Sonicators/PowerSupply/Electronics/Connectors.sch

## KiCad design Electronics/Connectors.sch (2015-08-16)

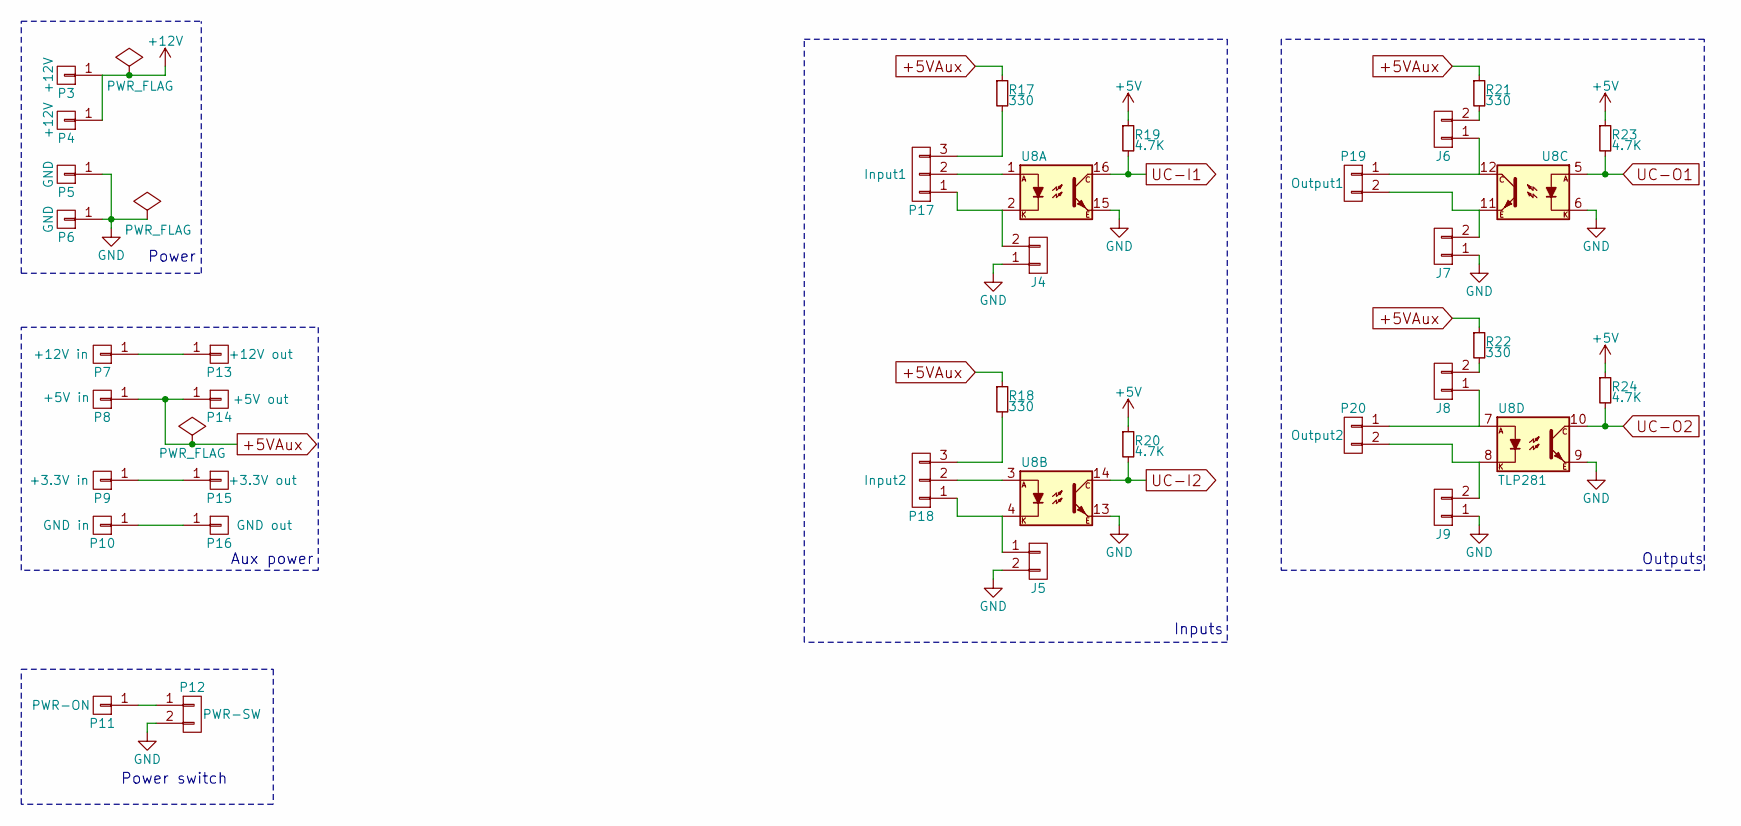
[picture p1: schematic Connectors.sch]

Parts:
J4: Input1
J5, J6, J7, J8, J9: CONN_01X02
P3, P4: +12V
P5, P6: GND
P7: +12V in
P8: +5V in
P9: +3.3V in
P10: GND in
P11: PWR-ON; SolderWirePad_single_2-5mmDrill
P12: PWR-SW; Pin_Header_Straight_1x02
P13: +12V out
P14: +5V out
P15: +3.3V out
P16: GND out
P17: Input1
P18: Input2
P19: Output1
P20: Output2
R17, R18, R21, R22: 330
R19, R20, R23, R24: 4.7K
U8: TLP281

Connections:
+5V: R19.1, R20.1, R23.1, R24.1
+5VAux: P8.1, P14.1, R17.1, R18.1, R21.1, R22.1
+12V: P3.1, P4.1
GND: J4.1, J5.2, J7.1, J9.1, P5.1, P6.1, P12.2, U8.6, U8.9, U8.13, U8.15
unnamed: J4.2, P17.1, U8.2
unnamed: J5.1, P18.1, U8.4
unnamed: J6.1, P19.1, U8.12
unnamed: J6.2, R21.2
unnamed: J7.2, P19.2, U8.11
unnamed: J8.1, P20.1, U8.7
unnamed: J8.2, R22.2
unnamed: J9.2, P20.2, U8.8
unnamed: P10.1, P16.1
unnamed: P11.1, P12.1
unnamed: P7.1, P13.1
unnamed: P9.1, P15.1
unnamed: P17.2, U8.1
unnamed: P17.3, R17.2
unnamed: P18.2, U8.3
unnamed: P18.3, R18.2
UC-I1: R19.2, U8.16
UC-I2: R20.2, U8.14
UC-O1: R23.2, U8.5
UC-O2: R24.2, U8.10

Notes on the sheet:
Aux power
Power
Inputs
Outputs
Power switch
