Sonicators/PowerSupply/Electronics/Microcontroller.sch

## KiCad design Electronics/Microcontroller.sch (2015-08-16)

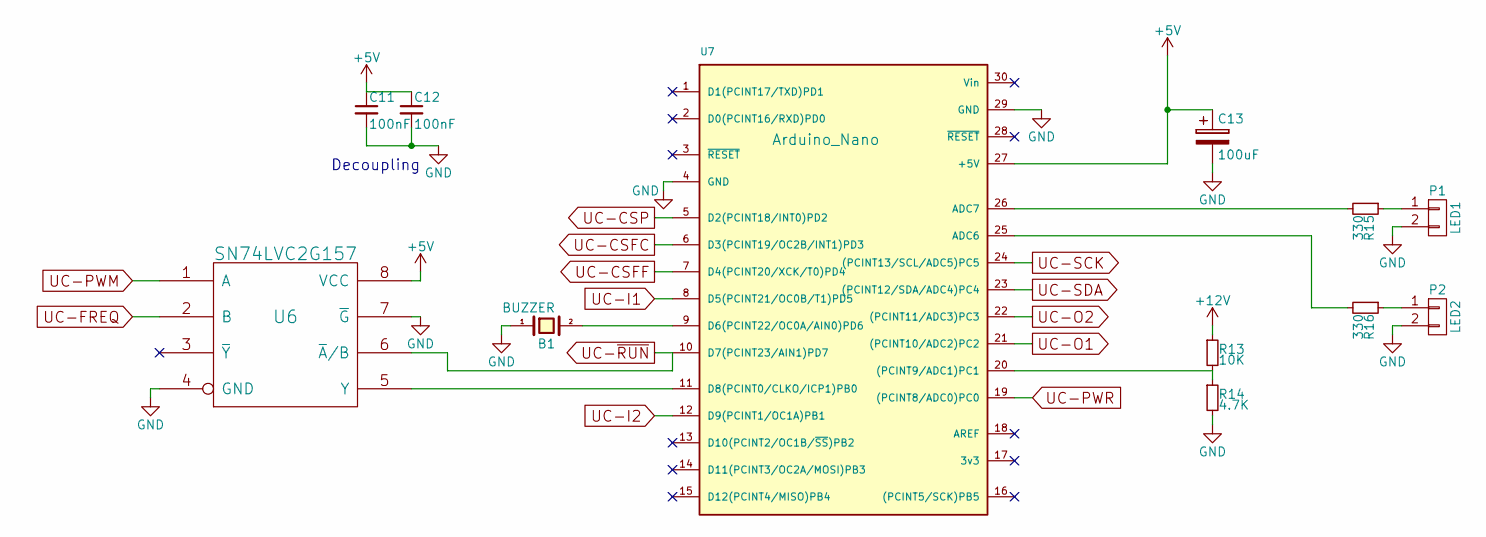
[picture p2: schematic Microcontroller.sch]

Parts:
B1: BUZZER
C11, C12: 100nF; C_0603_HandSoldering
C13: 100uF; c_elec_8x10.5
P1: LED1
P2: LED2
R13: 10K
R14: 4.7K
R15, R16: 330
U6: SN74LVC2G157
U7: Arduino_Nano

Connections:
+5V: C11.1, C12.1, C13.1, U6.8 (VCC), U7.27 (+5V)
+12V: R13.1
GND: B1.1, C11.2, C12.2, C13.2, P1.2, P2.2, R14.2, U6.4 (GND), U6.7 (~G), U7.4 (GND), U7.29 (GND)
unnamed: B1.2, U7.9 (D6(PCINT22/OC0A/AIN0)PD6)
unnamed: P1.1, R15.1
unnamed: P2.1, R16.1
unnamed: R13.2, R14.1, U7.20 ((PCINT9/ADC1)PC1)
unnamed: R15.2, U7.26 (ADC7)
unnamed: R16.2, U7.25 (ADC6)
unnamed: U6.5 (Y), U7.11 (D8(PCINT0/CLKO/ICP1)PB0)
UC-CSFC: U7.6 (D3(PCINT19/OC2B/INT1)PD3)
UC-CSFF: U7.7 (D4(PCINT20/XCK/T0)PD4)
UC-CSP: U7.5 (D2(PCINT18/INT0)PD2)
UC-FREQ: U6.2 (B)
UC-I1: U7.8 (D5(PCINT21/OC0B/T1)PD5)
UC-I2: U7.12 (D9(PCINT1/OC1A)PB1)
UC-O1: U7.21 ((PCINT10/ADC2)PC2)
UC-O2: U7.22 ((PCINT11/ADC3)PC3)
UC-PWM: U6.1 (A)
UC-PWR: U7.19 ((PCINT8/ADC0)PC0)
UC-SCK: U7.24 ((PCINT13/SCL/ADC5)PC5)
UC-SDA: U7.23 ((PCINT12/SDA/ADC4)PC4)
UC-~RUN: U6.6 (~A~/B), U7.10 (D7(PCINT23/AIN1)PD7)

Notes on the sheet:
Decoupling
