Sonicators/PowerSupply/Electronics/PowerDriver.sch

## KiCad design Electronics/PowerDriver.sch (2015-08-16)

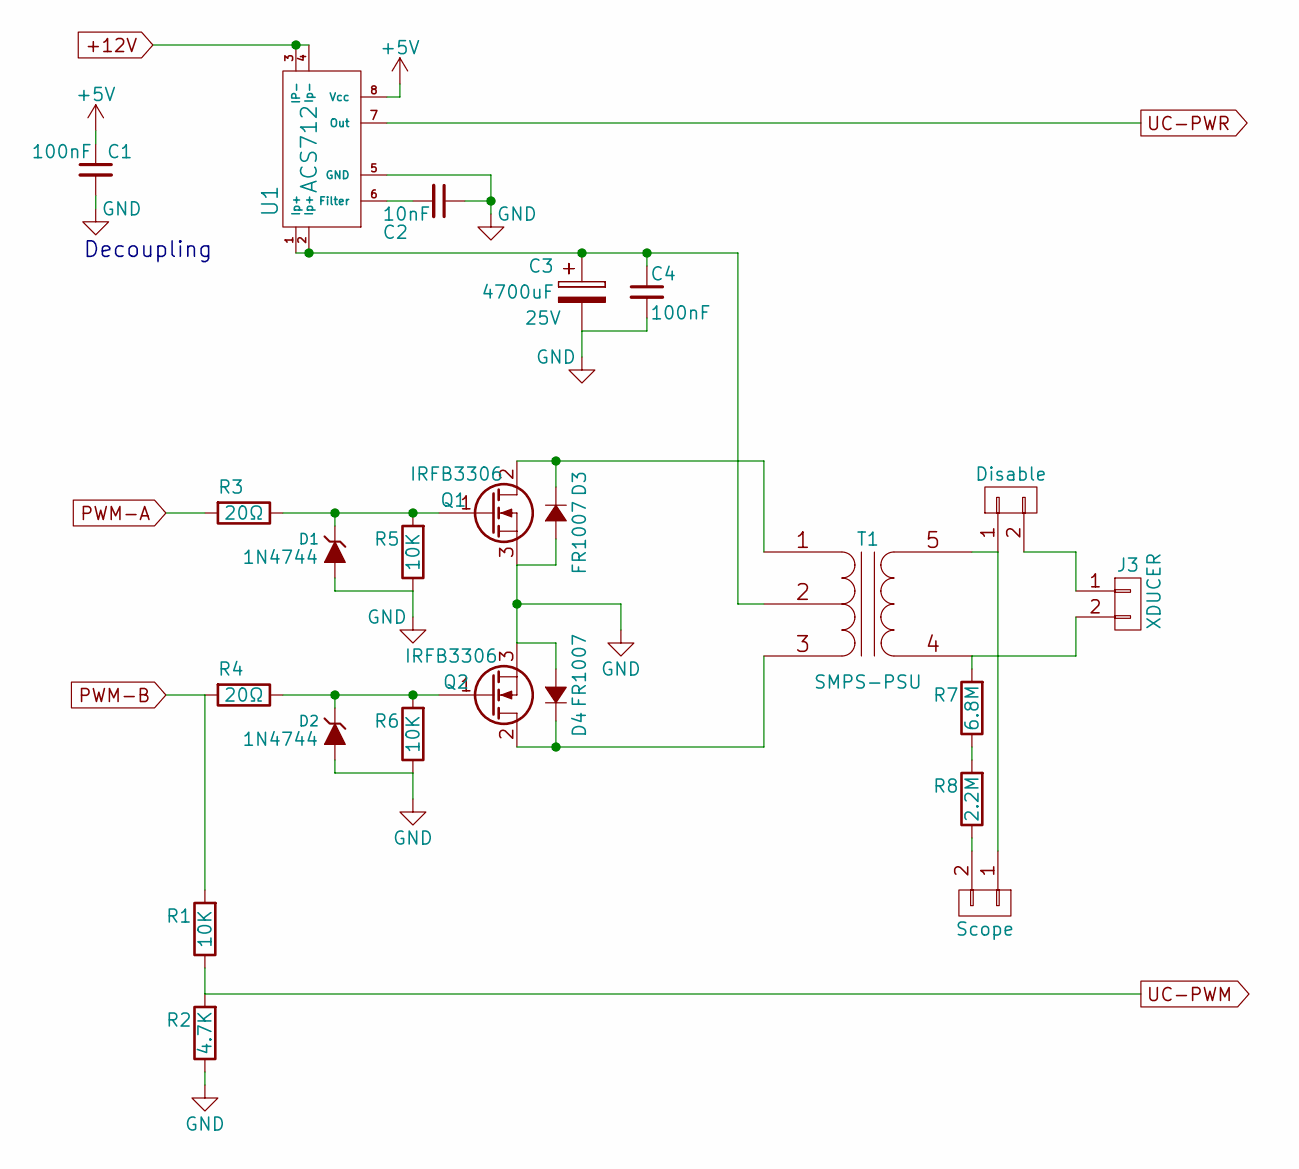
[picture p3: schematic PowerDriver.sch]

Parts:
C1, C4: 100nF; C_0603_HandSoldering
C2: 10nF; C_0603_HandSoldering
C3: 4700uF; Elko_vert_31.5x16mm_RM7.5; Voltage 25V
D1, D2: 1N4744; Diode-SMA_Handsoldering
D3, D4: FR1007; Diode-SMA_Handsoldering
J1: Scope; Pin_Header_Straight_1x02
J2: Disable; Pin_Header_Straight_1x02
J3: XDUCER
Q1, Q2: IRFB3306
R1, R5, R6: 10K
R2: 4.7K
R3, R4: 20Ω
R7: 6.8M
R8: 2.2M
T1: SMPS-PSU
U1: ACS712

Connections:
+5V: C1.1, U1.8 (Vcc)
+12V: U1.3 (IP-), U1.4 (Ip-)
GND: C1.2, C2.1, C3.2, C4.2, D1.1 (A), D2.1 (A), D3.1 (A), D4.1 (A), Q1.3 (S), Q2.3 (S), R2.1, R5.1, R6.1, U1.5 (GND)
unnamed: C2.2, U1.6 (Filter)
unnamed: C3.1, C4.1, T1.2 (PM), U1.1 (Ip+), U1.2 (Ip+)
unnamed: D1.2 (K), Q1.1 (G), R3.1, R5.2
unnamed: D2.2 (K), Q2.1 (G), R4.1, R6.2
unnamed: D3.2 (C), Q1.2 (D), T1.1 (PR1)
unnamed: D4.2 (C), Q2.2 (D), T1.3 (PR2)
unnamed: J1.1, J2.1, T1.5 (S2)
unnamed: J1.2, R8.1
unnamed: J2.2, J3.1
unnamed: J3.2, R7.2, T1.4 (S1)
unnamed: R7.1, R8.2
PWM-A: R3.2
PWM-B: R1.2, R4.2
UC-PWM: R1.1, R2.2
UC-PWR: U1.7 (Out)

Notes on the sheet:
Decoupling
