Sonicators/PowerSupply/Electronics/Switcher.sch

## KiCad design Electronics/Switcher.sch (2015-08-16)

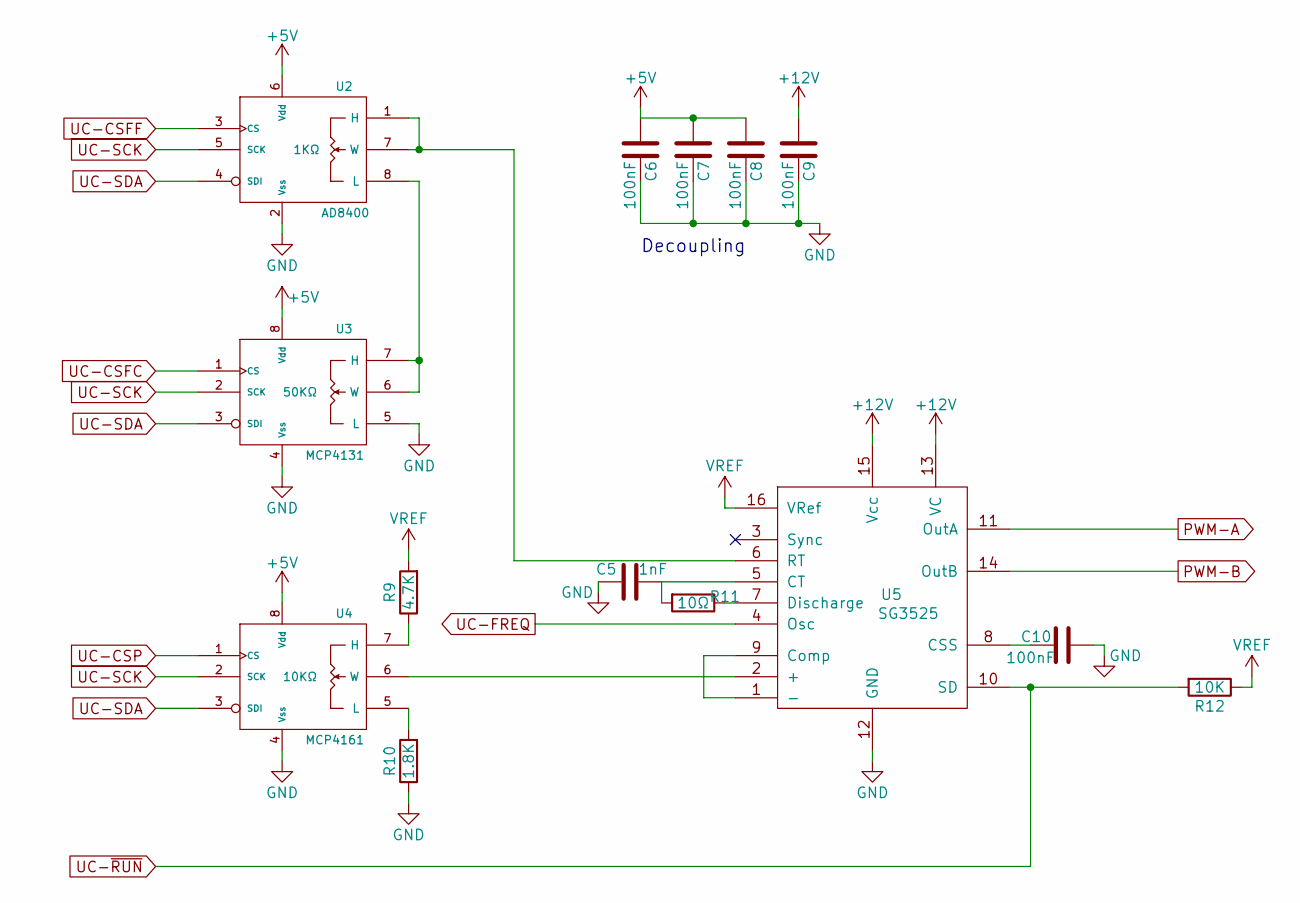
[picture p4: schematic Switcher.sch]

Parts:
C5: 1nF; C_0603_HandSoldering
C6, C7, C8, C9, C10: 100nF; C_0603_HandSoldering
R9: 4.7K
R10: 1.8K
R11: 10Ω
R12: 10K
U2: 1KΩ
U3: 50KΩ
U4: 10KΩ
U5: SG3525

Connections:
+5V: C6.2, C7.2, C8.2, U2.6 (Vdd), U3.8 (Vdd), U4.8 (Vdd)
+12V: C9.2, U5.13 (VC), U5.15 (Vcc)
GND: C5.1, C6.1, C7.1, C8.1, C9.1, C10.1, R10.1, U2.2 (Vss), U3.4 (Vss), U3.5 (L), U4.4 (Vss), U5.12 (GND)
unnamed: C5.2, R11.2, U5.5 (CT)
unnamed: C10.2, U5.8 (CSS)
unnamed: R9.1, U4.7 (H)
unnamed: R10.2, U4.5 (L)
unnamed: R11.1, U5.7 (Discharge)
unnamed: U2.1 (H), U2.7 (W), U5.6 (RT)
unnamed: U2.8 (L), U3.6 (W), U3.7 (H)
unnamed: U4.6 (W), U5.2 (+)
unnamed: U5.1 (-), U5.9 (Comp)
PWM-A: U5.11 (OutA)
PWM-B: U5.14 (OutB)
UC-CSFC: U3.1 (CS)
UC-CSFF: U2.3 (CS)
UC-CSP: U4.1 (CS)
UC-FREQ: U5.4 (Osc)
UC-SCK: U2.5 (SCK), U3.2 (SCK), U4.2 (SCK)
UC-SDA: U2.4 (SDI), U3.3 (SDI), U4.3 (SDI)
UC-~RUN: R12.2, U5.10 (SD)
VREF: R9.2, R12.1, U5.16 (VRef)

Notes on the sheet:
Decoupling
